cosmin-florescu25/class-ab-audio-amplifier/Poze/4.jpeg

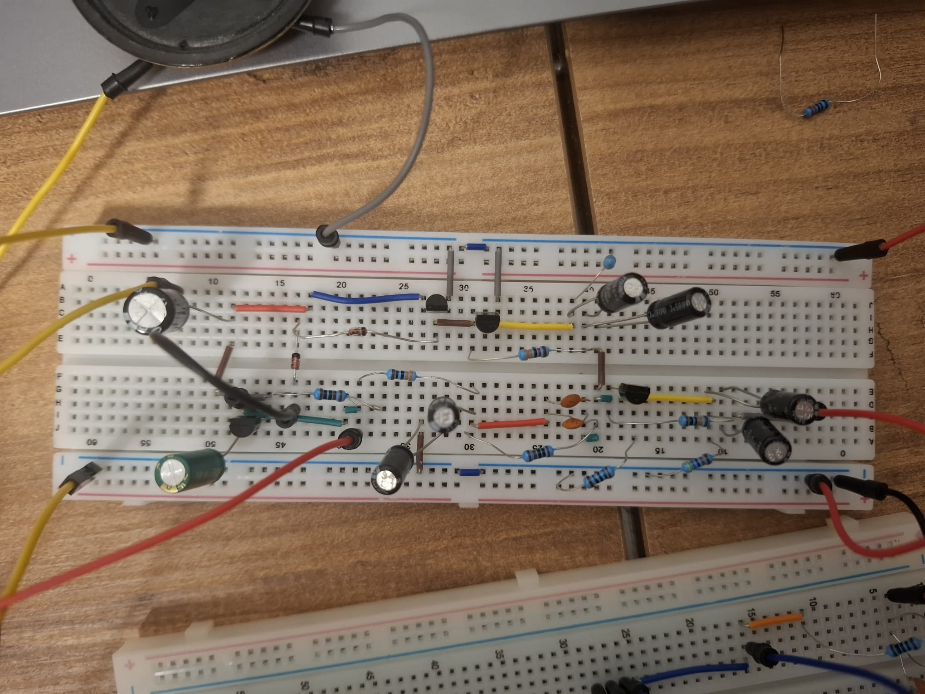
Poze/4.jpeg
