cosmin-florescu25/class-ab-audio-amplifier/Poze/1.jpeg

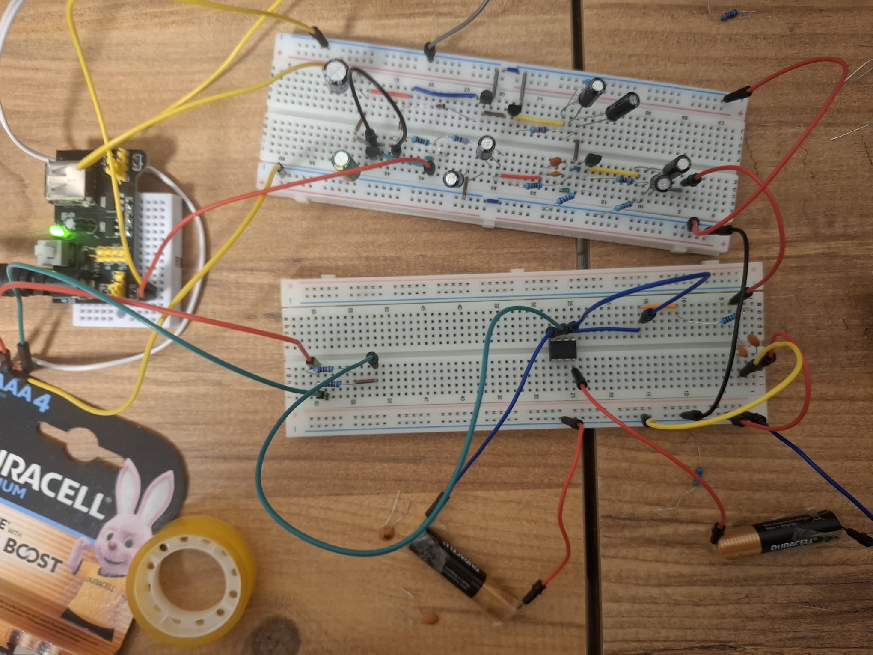
Poze/1.jpeg
