cosmin-florescu25/class-ab-audio-amplifier/Poze/2.jpeg

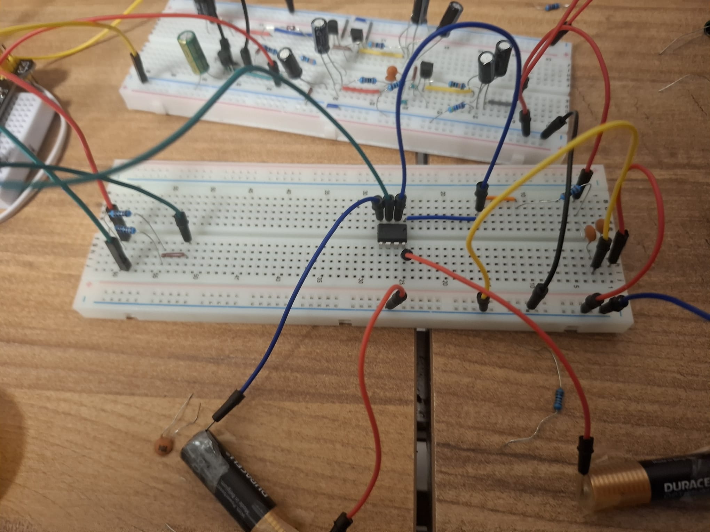
Poze/2.jpeg
