cosmin-florescu25/class-ab-audio-amplifier/Poze/3.jpeg

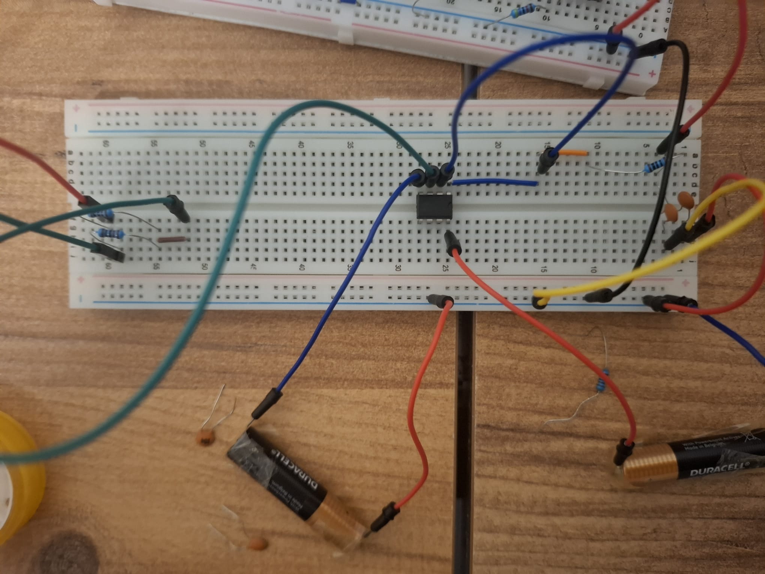
Poze/3.jpeg
