cosmin-florescu25/class-ab-audio-amplifier/Poze/5.jpeg

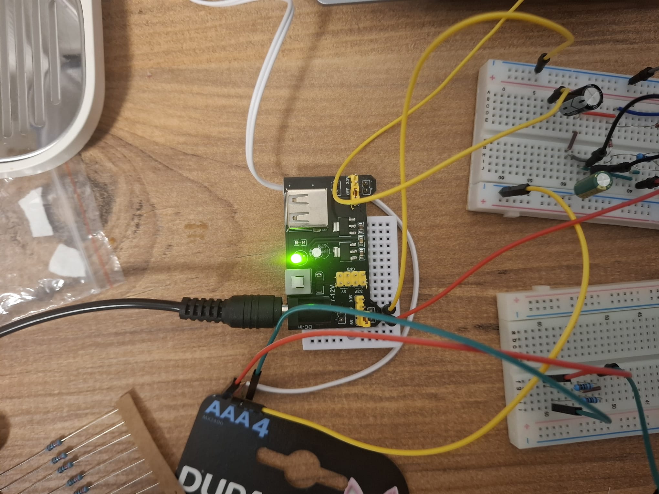
Poze/5.jpeg
