cosmin-florescu25/class-ab-audio-amplifier/AmplificatorAudio.asc

C1: polcap; 15µ
C2: polcap; 10µ
C3: polcap; 33n
C4: polcap; 10µ
C5: polcap; 220µ
C6: polcap; 100µ
D1: diode
D2: diode
Q1: npn; 2N2222
Q2: npn; 2N2222
Q3: npn; 2N2222
Q4: pnp; 2N2907
R1: res; 1K
R2: res; 47K
R3: res; 100K
R4: res; 1K
R5: res; 470
R6: res; 33K
R7: res; 33K
R8: res; 1K
R11: res; 1k
R_load: res; 8
U1: OP07
V1: voltage; 1.5
V2: voltage; 1.5
V_in: voltage; SINE(0 0.05 1K)
VCC: voltage; 5
Named nets: 0
.tran 2
